HWal/Meter_Pulses/Complete_Setup.jpg

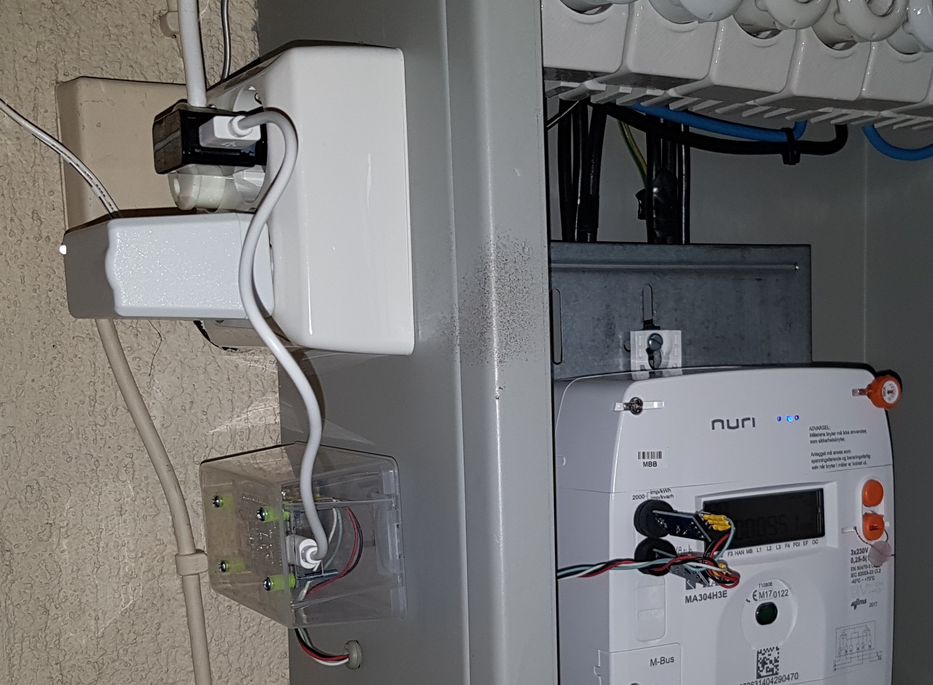
Complete_Setup.jpg
