HWal/Meter_Pulses/Meter.jpg

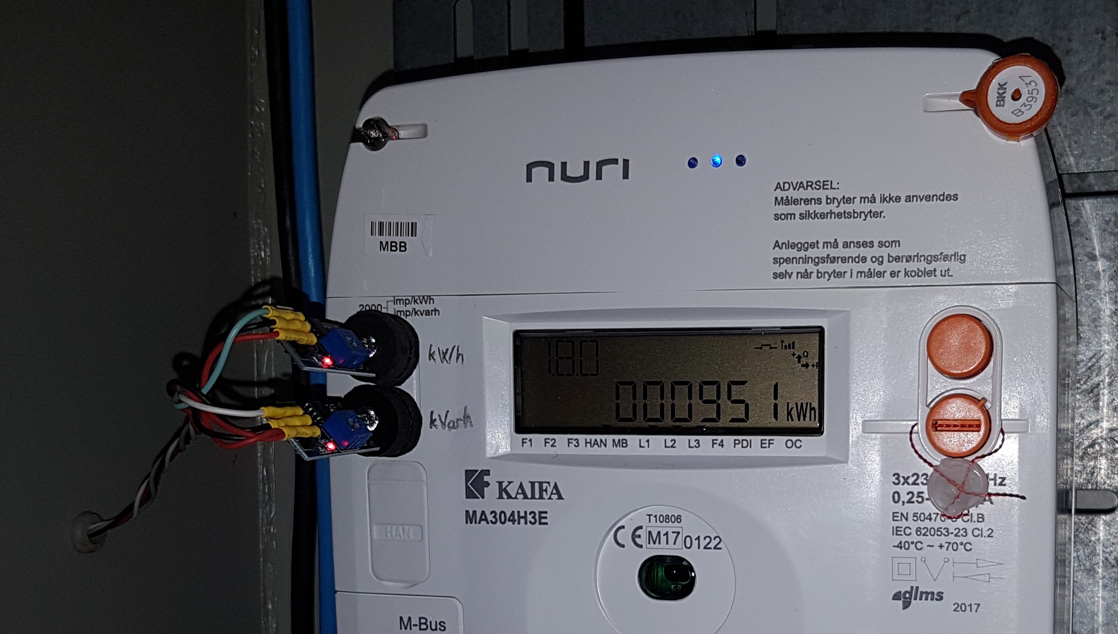
Meter.jpg
