HWal/Meter_Pulses/NodeMCU_v3_meter_pulses_EN.jpg

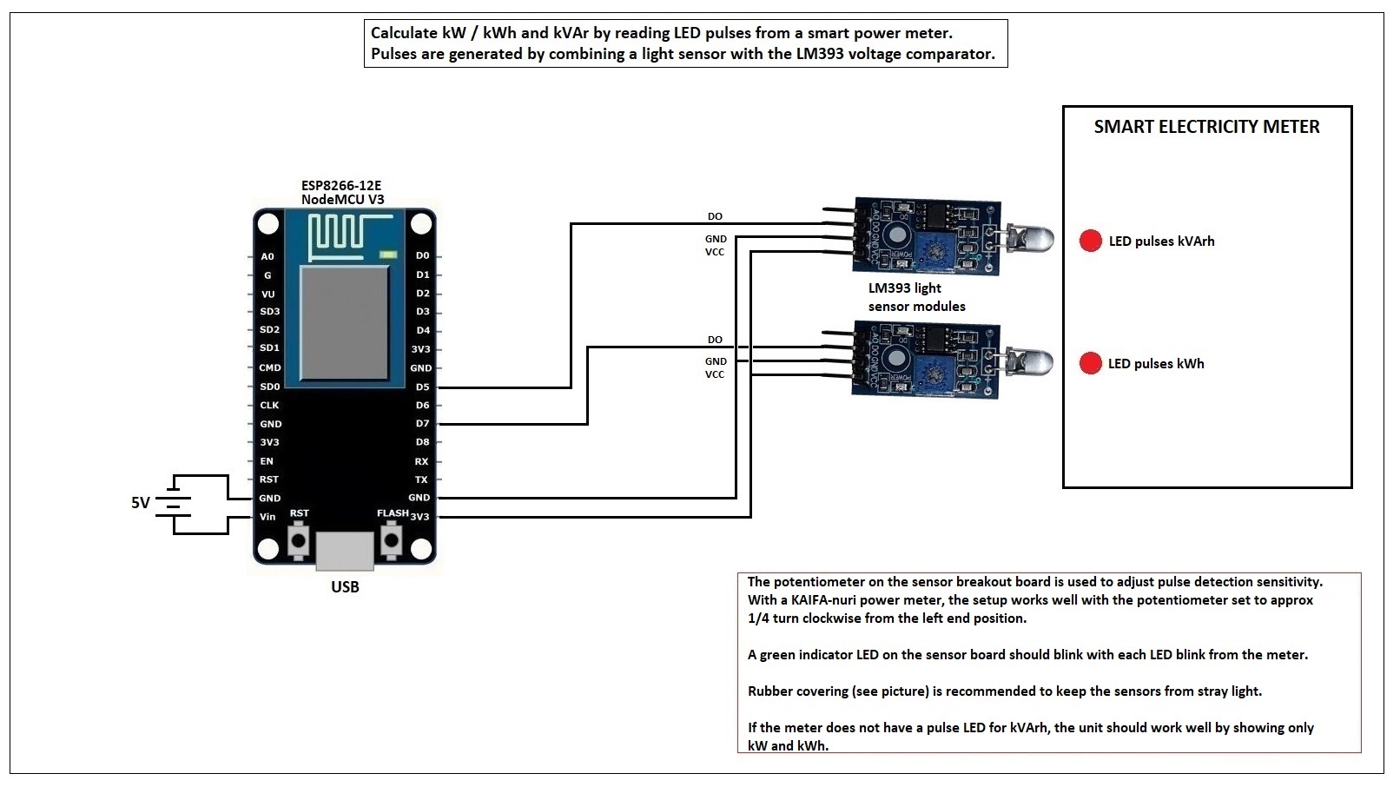
NodeMCU_v3_meter_pulses_EN.jpg
