HWal/Meter_Pulses/WEB_Screenshot.jpg

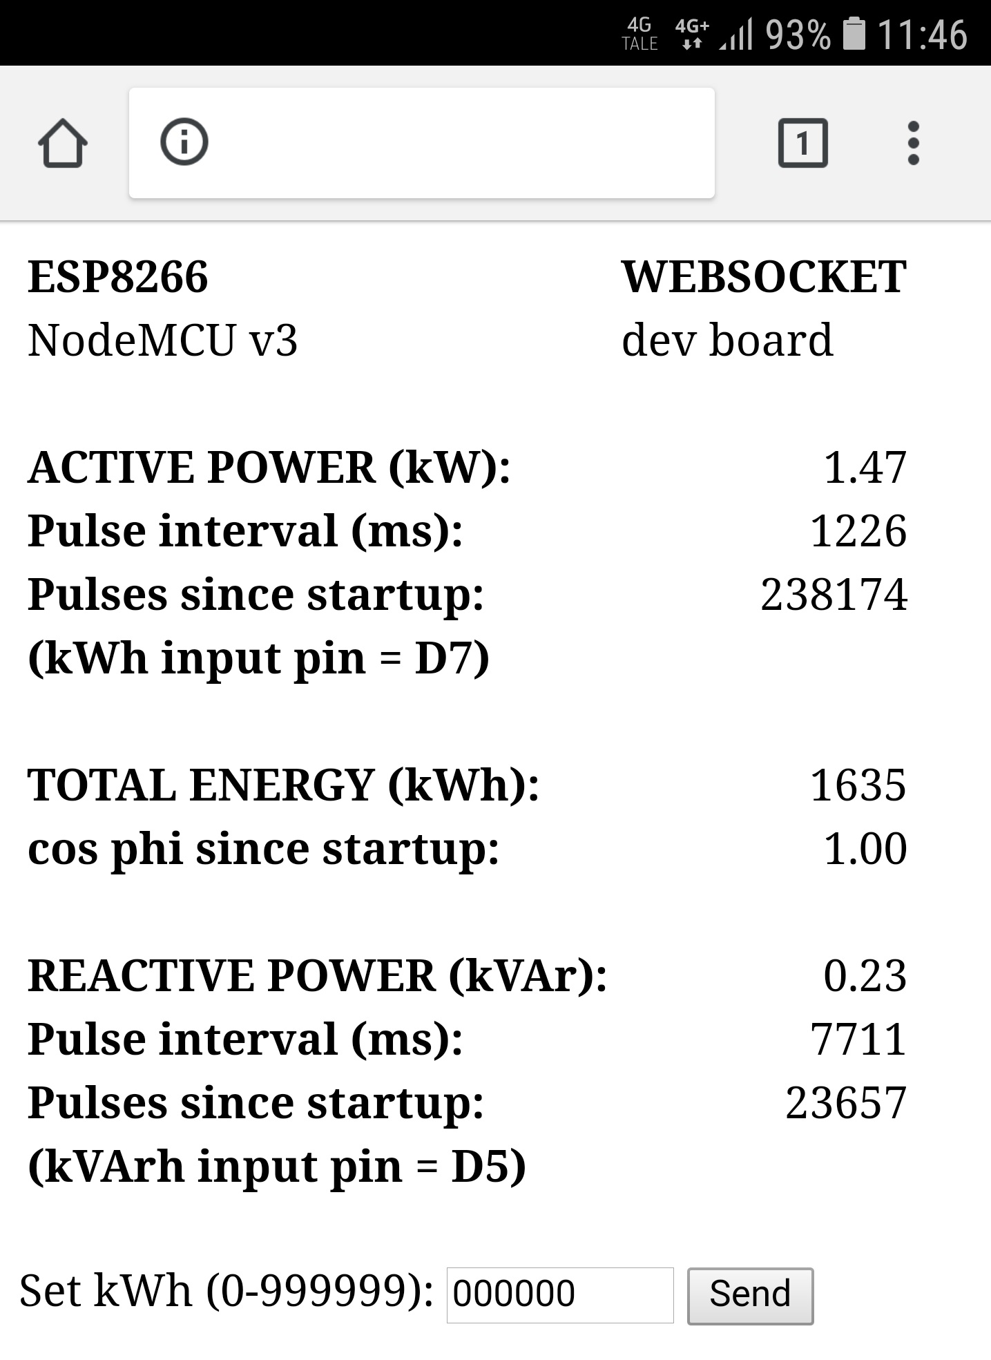
WEB_Screenshot.jpg
